daniela-luisa/IoT-Qualidade_Ambiental/(commit log)

2026-09-22 move credenciais para secrets.h e adiciona backend de decisao automatica
2026-10-20 feat: doc proposta de upgrade da N1
2026-10-27 mapa de pinos
    inclusao do documento mapa de pinos.md
